AxwellMz/lab1-acondicionamiento-alta-impedancia/docs/img/montaje/esquematico_proteus.png

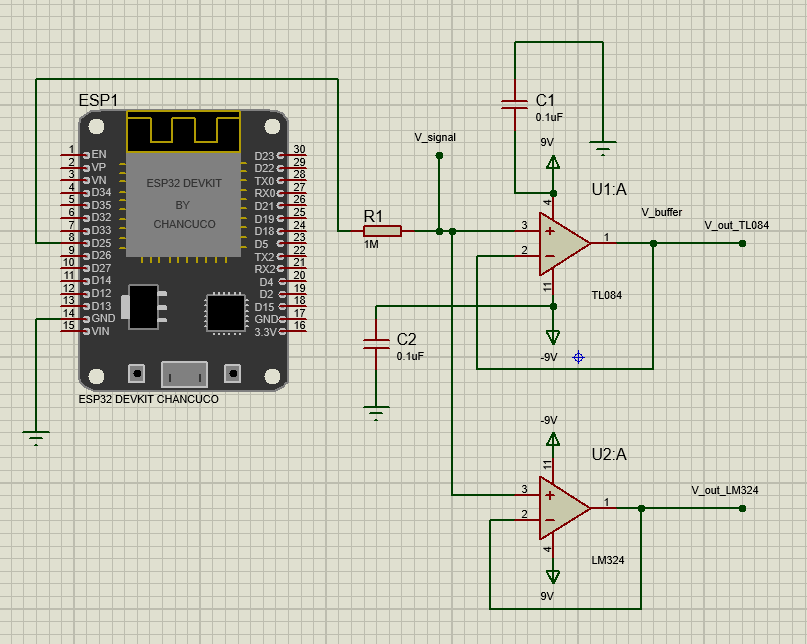
docs/img/montaje/esquematico_proteus.png
