AxwellMz/lab1-acondicionamiento-alta-impedancia/data/resultados_errores.csv

pH | V_teorico | V_multimetro_V | V_osciloscopio_V | V_TL084_V | V_LM324_V | e_NodoA_mult_% | e_NodoA_osc_% | e_TL084_% | e_LM324_% | Rin_mult_MOhm | Rin_osc_MOhm
4 | 2.29 | 1.17 | 1.06 | 2.31 | 2.319 | -48.9083 | -53.7118 | 0.8734 | 1.2664 | 1.0446 | 0.8618
7 | 1.64 | 0.79 | 0.72 | 1.65 | 1.665 | -51.8293 | -56.0976 | 0.6098 | 1.5244 | 0.9294 | 0.7826
10 | 0.97 | 0.47 | 0.4 | 0.99 | 0.994 | -51.5464 | -58.7629 | 2.0619 | 2.4742 | 0.94 | 0.7018
