AxwellMz/lab1-acondicionamiento-alta-impedancia/(list of files, drawings)

Other design files:
hardware/proteus/Labo_1-Ckto_Final-IB_III.pdsprj
hardware/proteus/Labo_1-Ckto_Part_1-IB_III.pdsprj
hardware/proteus/Labo_1-Ckto_Part_2-IB_III.pdsprj
hardware/proteus/Labo_1-Ckto_Part_3-IB_III.pdsprj
